atireksd11/Astra-Companion/cad/README.md

# CAD exports

| File | Description |
|---|---|
| [`astra-companion-chassis-assembly.step`](astra-companion-chassis-assembly.step) | Full mechanical assembly (PETG shell, head, chassis plate, motor mounts). Exported from the main Fusion design (`micro_robot_assembly`). |

Open in Fusion 360, FreeCAD, or Onshape. Week 2 Half Life repo copy: [Astra-Companion-Cad](https://github.com/atireksd11/Astra-Companion-Cad).

Renders live in [`docs/images/`](../docs/images/).

Week 4 eye plastic (empty until the model exists): [`eyes/`](eyes/).
