atireksd11/Astra-Companion/docs/README.md

# Docs

| Doc | Contents |
|-----|---|
| [`DEVELOPMENT.md`](DEVELOPMENT.md) | Repo map, firmware modules, weekly scope |
| [`FEATURE19_PHASE6.md`](FEATURE19_PHASE6.md) | Robot `done.actions[]` on ESP32, contract tests, verification |
| [`ROBOT_BRINGUP.md`](ROBOT_BRINGUP.md) | secrets.h, flash, bridge, laptop or robot voice, troubleshooting |
| [`PINOUT.md`](PINOUT.md) | ESP32-S3 GPIO map from the KiCad netlist |
| [`CAD.md`](CAD.md) | Week 2 chassis, prints, mechanical BOM |
| [`WEEK4_EYES.md`](WEEK4_EYES.md) | Dual GC9A01 eyes: plan, pins, later code and CAD folders |
| [`../hardware/BOM_AUDIO_MODULE.md`](../hardware/BOM_AUDIO_MODULE.md) | Audio side box, neck bearings, and MG90S |
| [`HALF_LIFE.md`](HALF_LIFE.md) | Week 1 vs Week 2 upload checklist |
| [`images/`](images/) | PCB render + CAD screenshots for README / Half Life |

Half Life devlog copy lands in root `JOURNAL.md` (synced from the site).
