atireksd11/Astra-Companion/extrude/README.md

# extrude

not this week either.

idea is: throw `astracompanion.ato` at a checker (erc / spice / whatever) and see if it catches dumb stuff like missing pullups or the 6V-into-5V thing.

the robot is the test case. first i have to have a board.
