atireksd11/Astra-Companion/cad/eyes/README.md

# Eye mechanics (Week 4)

Plastic for the two round GC9A01 eyes. The circuit is already on the carrier board. Fusion source stays in [Astra-Companion-Cad](https://github.com/atireksd11/Astra-Companion-Cad). Copy STEP or STL files into the folders below when the model exists.

| Folder | What lands here |
|---|---|
| [bezels/](bezels/) | Printed rings in front of each screen |
| [screen-mounts/](screen-mounts/) | Clips or pockets that hold the 1.28 inch modules |
| [pupil-art/](pupil-art/) | Drawings of the iris and status marks, not 3D parts |

Photos of those parts go in `docs/images/eyes/`. The week plan is [docs/WEEK4_EYES.md](../../docs/WEEK4_EYES.md).
