atireksd11/Astra-Companion/server/detectors/README.md

# Detectors

Each detector reads a `Turn` and writes scores into `turn.notes`.

- **free** — plain math on the robot or laptop
- **cheap** — small local model
- **paid** — cloud API

Detectors that the reply does not need run after the reply starts.
