atireksd11/Astra-Companion/docs/images/cad-exploded.png

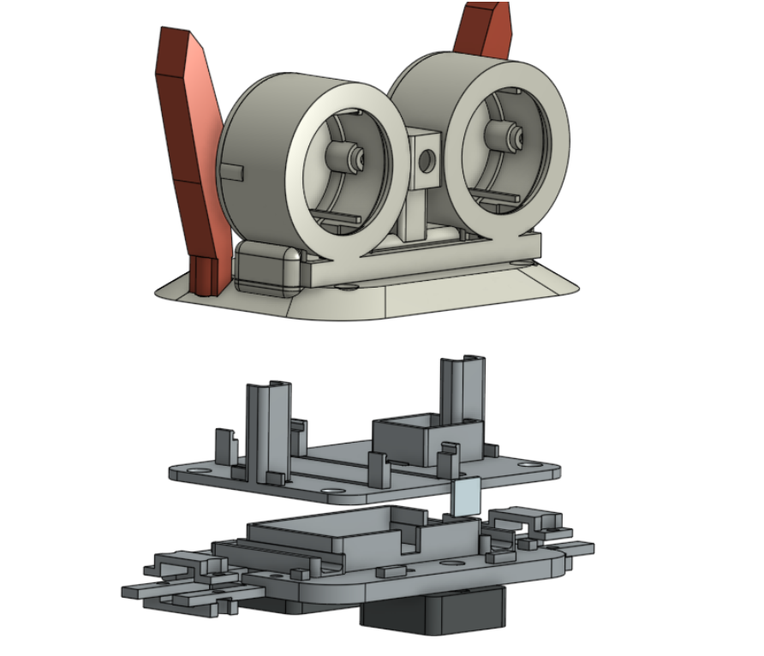
docs/images/cad-exploded.png
