atireksd11/Astra-Companion/docs/images/cad-front.png

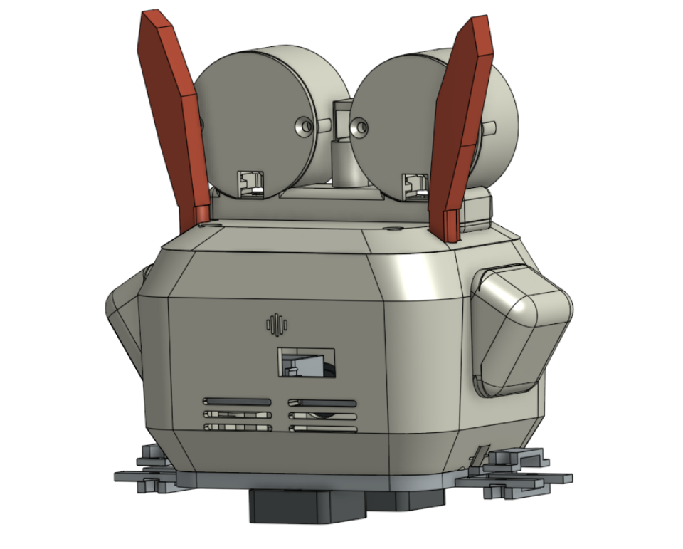
docs/images/cad-front.png
