atireksd11/Astra-Companion/docs/images/cad-iso.png

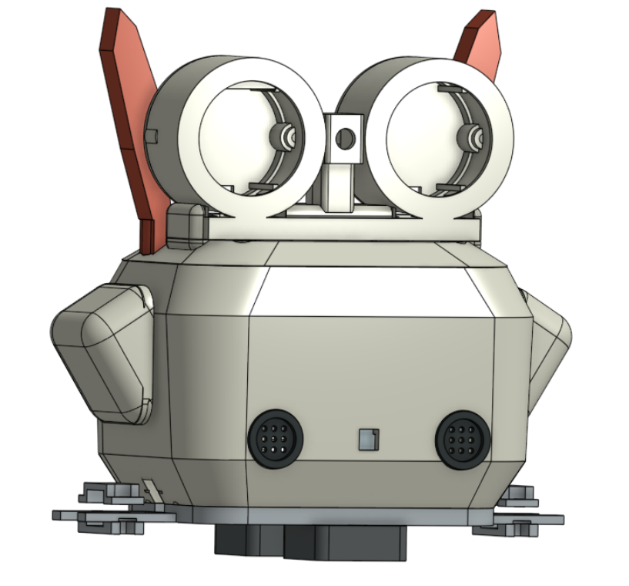
docs/images/cad-iso.png
