atireksd11/Astra-Companion/docs/images/cad-pcb-stack.png

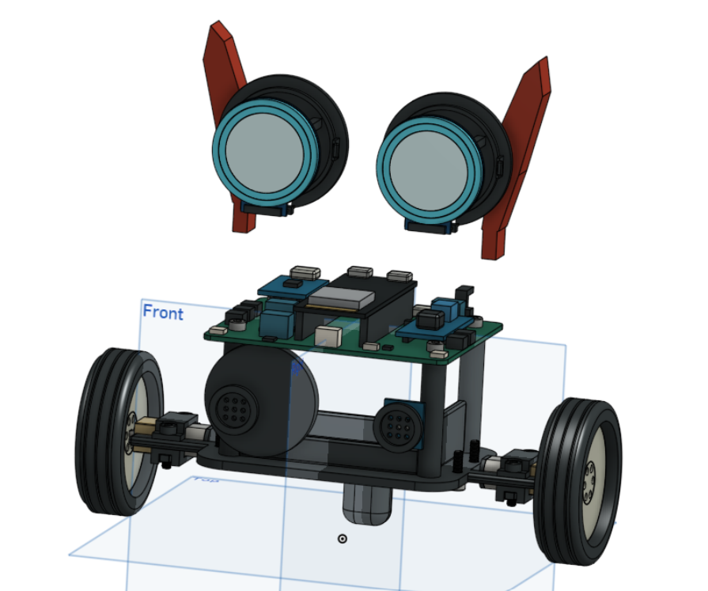
docs/images/cad-pcb-stack.png
