atireksd11/Astra-Companion/docs/images/cad-wheels.png

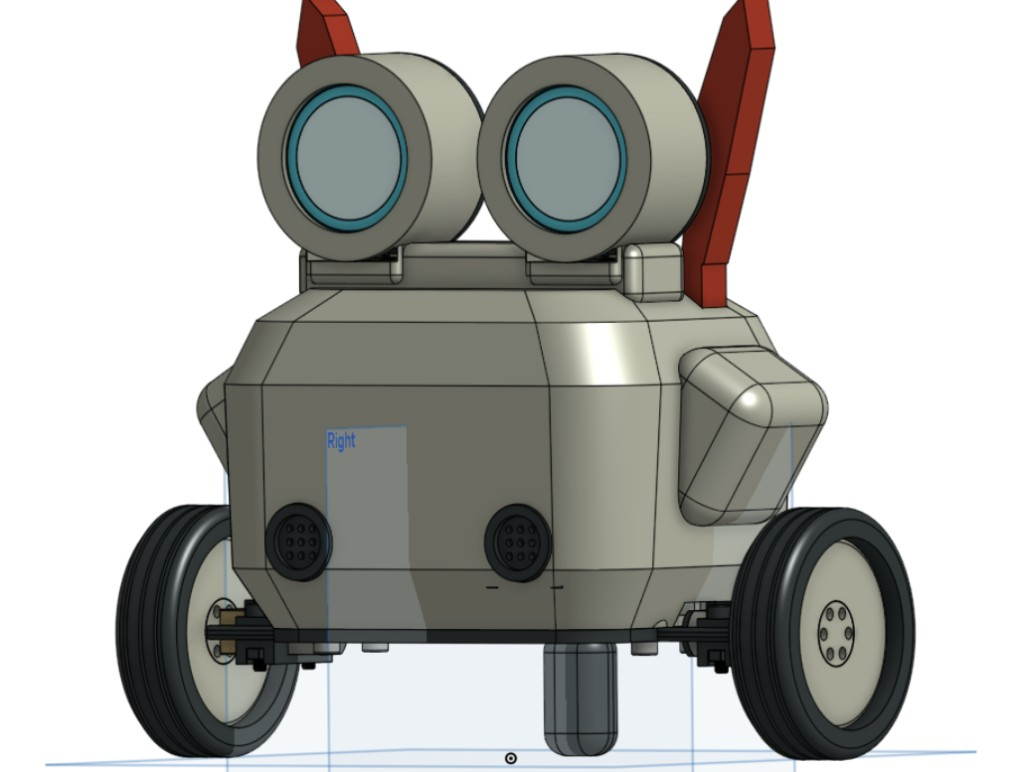
docs/images/cad-wheels.png
