atireksd11/Astra-Companion/hardware/BOM_AUDIO_MODULE.md

# Audio module and neck pivot (this week)

Mechanical parts for the side speaker box, the neck pivot, and head pan. These fit the printed chassis in [Astra-Companion-Cad](https://github.com/atireksd11/Astra-Companion-Cad). The carrier PCB still has INMP441 and MAX98357A. This week is mostly plastic, bearings, and a stronger servo.

Grant import file: [bom-audio-module.csv](bom-audio-module.csv).

| Part | Qty | Unit | Total | Where |
|---|-----|---|---|---|
| [PGN 608-ZZ ball bearings](https://www.amazon.ca/gp/product/B07XLV1W2M/ref=ox_sc_act_title_2?smid=A3RMJZMAP3U4RK&psc=1) (10 pack, 8 by 22 by 7 mm) | 10 | $1.30 | $12.95 | Amazon.ca |
| [MG90S metal gear micro servo](https://www.amazon.ca/gp/product/B0BHYHKF2P/ref=ox_sc_act_title_1?smid=A1AEYBYG92X8UY&psc=1) (2 pack) | 2 | $7.50 | $14.99 | Amazon.ca |
| Tax and shipping | | | about $5.00 | Prime / domestic |

Parts subtotal is **$27.94** before tax and shipping. Unit price is per piece. The totals are the pack prices Amazon charges.

## What each part does

The **608-ZZ bearings** sit at the top and bottom of the neck so the head turns smoothly without grinding on printed plastic.

The **MG90S servos** use metal gears so pan motion does not strip like the old SG90. One servo moves the head left and right. The second from the pack is a spare or a future tilt axis.

## CAD renders

Exploded view of the head, speaker side panel, and neck stack:

Audio module exploded

Rear view with the vented speaker box on the body:

Audio module rear

Inside the torso showing the speaker and board bay:

Audio module internal

Side panel, gasket plates, and speaker mount detail:

Audio module side detail
