atireksd11/Astra-Companion/hardware/BOM_NEEDS_PRICE.md

# BOM pricing notes

**PCB (Week 1):** all lines priced in [`bom.csv`](bom.csv). Tax/shipping math in [`BOM_SUMMARY.md`](BOM_SUMMARY.md).

**CAD (Week 2):** all lines priced in [`bom-cad.csv`](bom-cad.csv). Tier 1 cap in [`BOM_CAD_SUMMARY.md`](BOM_CAD_SUMMARY.md).

Half Life tax field for PCB tier (with ~$96 parts): **`7.00` USD** on the form; you cover the rest of tax and all shipping.
