atireksd11/Astra-Companion/hardware/BOM.md

# Astra Companion — bill of materials

<!-- Generated by Half Life from project cmuvgfgnh00a901q9t8ie3rrb. Edits here are overwritten on the next sync. -->
<!-- Generated: 1970-01-01T00:00:00.000Z -->

> [!NOTE]
> This parts list is mirrored from [Half Life](https://halflife.hackclub.com). Editing it here will not change the platform's copy, and the next sync overwrites this file.

| Week | Tier | Parts funding |
| --- | --- | --- |
| Week 1 | Tier 2 | $65.00 |

The importer that already read this repo uses `hardware/bom.csv` with columns Part, Purpose, Qty, Unit Price (USD), Total Price (USD), Vendor, Link, Notes. Root `BOM.md` has no part columns of its own. The table below is the same list. Qty is the quantity that has to be purchased. PCB manufacturing, shipping, and tax are not included.

| Part | Purpose | Qty | Unit Price (USD) | Total Price (USD) | Vendor | Link | Notes |
| --- | --- | --- | --- | --- | --- | --- | --- |
| ESP32-S3-DEVKITC-1-N8R8 | Main controller. Plugs into U2. | 1 | 15.00 | 15.00 | Mouser | https://www.mouser.com/ProductDetail/Espressif-Systems/ESP32-S3-DevKitC-1-N8R8 | Existing vendor and link kept. Page not reopened on 2026-10-12. Buy 1. |
| DRV8833PWPR | Dual H-bridge. U3. | 1 | 2.10 | 2.10 | LCSC | https://www.lcsc.com/product-detail/C50506.html | Existing vendor and link kept. Page not reopened on 2026-10-12. Buy 1. |
| GC9A01 1.28in 240x240 round LCD module | Round eyes. DS1 and DS2. | 2 | 8.90 | 17.80 | Makerfabs | https://www.makerfabs.com/gc9a01-1-28-inch-round-lcd-module.html | Existing vendor and link kept. Page not reopened on 2026-10-12. Buy 2. |
| MPU-6050 | Balance gyro. U5 bare QFN. | 1 | 20.23 | 20.23 | LCSC | https://www.lcsc.com/product-detail/C24112.html | Existing vendor and link kept. Page not reopened on 2026-10-12. Buy 1. A cheaper module is a later cost cut. The design is unchanged. |
| DS3231M+TRL | Real-time clock. U6. 16-pin wide SOIC. | 1 | 14.29 | 14.29 | DigiKey | https://www.digikey.com/en/products/detail/analog-devices-inc-maxim-integrated/DS3231M-TRL/2402421 | Checked 2026-10-12. Cut-tape price. Package on the page is 16-SOIC, 0.295 inch (7.50 mm) wide. This is not the 8-pin MZ part. Digi-Reel would add a $7 fee, which is not included. |
| VL53L0CXV0DH/1 | Distance sensor. U8. | 1 | 5.18 | 5.18 | Mouser | https://www.mouser.com/ProductDetail/STMicroelectronics/VL53L0CXV0DH-1 | Existing vendor and link kept. Page not reopened on 2026-10-12. Buy 1. The board footprint is still the VL53L1x pattern. |
| MAX98357AETE+T | I2S speaker amplifier. U4. | 1 | 1.33 | 1.33 | LCSC | https://www.lcsc.com/product-detail/C910544.html | Existing vendor and link kept. Page not reopened on 2026-10-12. Buy 1. |
| INMP441 I2S microphone module, 6-pin | Microphone. MK1. | 1 |  |  |  |  | Needs a page that states 6 pins and a USD price. The Elecrow page opened on 2026-10-12 is $5.00 but does not say the pin count. |
| MAX17048G+T10 | Fuel gauge. U10. | 1 | 2.17 | 2.17 | LCSC | https://www.lcsc.com/product-detail/C2682616.html | Existing vendor and link kept. Page not reopened on 2026-10-12. Buy 1. |
| MT3608 boost module | Motor-rail boost. U1. | 1 | 0.95 | 0.95 | ProtoSupplies | https://protosupplies.com/product/mt3608-mini-adjustable-dc-dc-boost-module/ | Existing vendor and link kept. Page not reopened on 2026-10-12. Buy 1. |
| AP2112K-3.3TRG1 | 3.3V regulator. U7. | 5 | 0.08 | 0.40 | LCSC | https://www.lcsc.com/product-detail/C51118.html | Existing vendor and link kept. Page not reopened on 2026-10-12. Minimum buy is 5. One is used. |
| AO3401A | Display power switch. Q4. | 10 | 0.06 | 0.60 | LCSC | https://www.lcsc.com/product-detail/C15127.html | Existing vendor and link kept. Page not reopened on 2026-10-12. Minimum buy is 10. One is used. |
| USBLC6-2SC6 | USB ESD diode. U11. | 5 | 0.18 | 0.90 | LCSC | https://www.lcsc.com/product-detail/C7519.html | Existing vendor and link kept. Page not reopened on 2026-10-12. Minimum buy is 5. One is used. |
| USBLC6-4SC6 | ESD diode. U13. | 5 | 0.17 | 0.85 | LCSC | https://www.lcsc.com/product-detail/C111212.html | Existing vendor and link kept. Page not reopened on 2026-10-12. Minimum buy is 5. One is used. |
| TYPE-C-31-M-12 | USB-C receptacle. J4. | 5 | 0.19 | 0.95 | LCSC | https://www.lcsc.com/product-detail/C165948.html | Existing vendor and link kept. Page not reopened on 2026-10-12. Minimum buy is 5. One is used. |
| PTS645 tactile switch | User buttons. SW1 SW3 SW6. | 5 | 0.21 | 1.05 | LCSC | https://www.lcsc.com/product-detail/C221880.html | Existing vendor and link kept. Page not reopened on 2026-10-12. Minimum buy is 5. Three are used. |
| WS2812B | Status LEDs. D7 and D8. | 5 | 0.10 | 0.50 | LCSC | https://www.lcsc.com/product-detail/C114586.html | Existing vendor and link kept. Page not reopened on 2026-10-12. Minimum buy is 5. Two are used. |
| 0.1uF 0805 capacitor | Decoupling. | 20 | 0.02 | 0.40 | LCSC | https://www.lcsc.com/product-detail/C1711.html | Existing vendor and link kept. Page not reopened on 2026-10-12. Minimum buy is 20. Eighteen 0805 parts are on the board. |
| TP4056 USB-C charger module with DW01 | Charger. TP1. | 1 |  |  |  |  | Needs a USD page. The module must show IN+ IN- B+ B- OUT+ OUT- and a DW01 chip. No page opened on 2026-10-12 stated all of that in USD. |
| Slide switch | Power switch. SW2. | 1 |  |  |  |  | Schematic footprint name is SW_Slide_SPDT_Straight_CK_OS102011MS2Q. No USD page opened on 2026-10-12. |
| Molex 1040310811 microSD slot | Card socket. J6. | 1 | 2.21 | 2.21 | DigiKey | https://www.digikey.com/en/products/detail/molex/1040310811/2370379 | Checked 2026-10-12. Cut-tape price for one. Description: microSD card connector, surface mount, right angle. Digi-Reel would add a $7 fee, which is not included. |
| CR2032 coin cell holder | Coin cell holder. BT2. | 1 |  |  |  |  | Footprint name is BatteryHolder_Keystone_3000. No price page opened on 2026-10-12. |
| CR2032 coin cell | Cell for BT2. | 1 |  |  |  |  | No price page opened on 2026-10-12. |
| BAT54C | Diode. D5. | 1 |  |  |  |  | No price page opened on 2026-10-12. |
| 1N5819 | Schottky diode. D1. | 1 |  |  |  |  | No price page opened on 2026-10-12. |
| Phoenix screw terminal 1x2 | J1 and J2. | 2 |  |  |  |  | No price page opened on 2026-10-12. |
| Metz screw terminal 1x2 | J5. | 1 |  |  |  |  | No price page opened on 2026-10-12. |
| Pin header 1x7 | Display connectors. DS1 and DS2. | 2 |  |  |  |  | No price page opened on 2026-10-12. |
| Pin header 1x6 | Header for the TP4056 module. TP1. | 1 |  |  |  |  | No price page opened on 2026-10-12. |
| Pin header 1x4 | Header for the boost module. U1. | 1 |  |  |  |  | No price page opened on 2026-10-12. |
| JST SH 4-pin 1.0 mm connector plus cable | I2C connector. J7. | 1 |  |  |  |  | Needs one listing that includes the connector and the cable. No price page opened on 2026-10-12. |
| Pin header 1x3 | Servo headers. J3 and J10. | 2 |  |  |  |  | No price page opened on 2026-10-12. |
| Fan pin header 1x3 | Encoder connectors. J9 and Jd1. | 2 |  |  |  |  | No price page opened on 2026-10-12. |
| Pin header 1x1 | Test point. J8. | 1 |  |  |  |  | No price page opened on 2026-10-12. |
| Female header 1x22 | Sockets for the DevKit. | 2 |  |  |  |  | No price page opened on 2026-10-12. The symbol has 22 pins per side. The placed footprint is 2x19. |
| JST PH 2-pin plus 18650 holder with leads | Battery plug and holder. BT1. | 1 |  |  |  |  | No single page opened on 2026-10-12 sells this pair. The Keystone 1042 row is deleted because that footprint is not on the board. |
| 10k 0805 resistor | Pull-ups. R1 R9 R12 R13 R14 R15 R16 R17 R18 R19 R20 R27 R29 R30 R32 R36 R37 R38. | 100 | 0.0034 | 0.34 | LCSC | https://www.lcsc.com/product-detail/C881248.html | Checked 2026-10-12. EVER OHMS CR0805F10K0P05Z, 10k 1% 0805. Need 18. Minimum purchase is 100 at $0.0034, total $0.34. |
| 5.1k axial resistor | R4 and R5. | 2 |  |  |  |  | No price page opened on 2026-10-12. |
| 2.2k 0805 resistor | R10 and R11. | 2 |  |  |  |  | No price page opened on 2026-10-12. |
| 1k 0805 resistor | R25. | 1 |  |  |  |  | No price page opened on 2026-10-12. |
| 100k 0805 resistor | R28. | 1 |  |  |  |  | No price page opened on 2026-10-12. |
| 330 ohm 0805 resistor | R39. | 100 | 0.0029 | 0.29 | LCSC | https://www.lcsc.com/product-detail/C881004.html | Checked 2026-10-12. EVER OHMS CR0805J330RP05Z, 330 ohm 5% 0805. Need 1. Minimum purchase is 100 at $0.0029, total $0.29. |
| 0.2 ohm 1% resistor, 0.5 W or higher | R23 and R24. | 2 |  |  |  |  | No page opened on 2026-10-12 showed this value, tolerance, and power rating with a USD price. |
| 2.2uF 0805 capacitor | C14 and C50. | 2 |  |  |  |  | No price page opened on 2026-10-12. |
| 10uF 1206 capacitor | C4 C24 C26 C28. | 4 |  |  |  |  | No price page opened on 2026-10-12. |
| 10uF 0805 capacitor | C15. | 1 |  |  |  |  | No price page opened on 2026-10-12. |
| 22uF 0805 capacitor | C20. | 1 |  |  |  |  | No price page opened on 2026-10-12. |
| 100uF radial capacitor | C2. | 1 |  |  |  |  | No price page opened on 2026-10-12. |
| 100uF electrolytic capacitor | C23. | 1 |  |  |  |  | No price page opened on 2026-10-12. |
| 1000uF radial capacitor | C3. | 1 |  |  |  |  | No price page opened on 2026-10-12. |
| 2.2nF 0805 capacitor | C12. | 1 |  |  |  |  | No price page opened on 2026-10-12. |
| 10nF 0805 capacitor | C10 and C19. | 2 |  |  |  |  | No price page opened on 2026-10-12. |
| 1uF disc capacitor | C1. | 1 |  |  |  |  | No price page opened on 2026-10-12. |
| 0.1uF disc capacitor | C8. | 1 |  |  |  |  | No price page opened on 2026-10-12. |
| 0.1uF 0603 capacitor | C13. | 1 |  |  |  |  | No price page opened on 2026-10-12. |
| LED 0805 | D3. | 1 |  |  |  |  | No price page opened on 2026-10-12. |
| Reset button | SW4. | 1 |  |  |  |  | No price page opened on 2026-10-12. |
| Boot button | SW5. | 1 |  |  |  |  | No price page opened on 2026-10-12. |
| 6V N20 micro gear motor with rubber wheel, 1 pair | Wheel motors. Two motors. | 1 | 18.39 | 18.39 | RobotShop | https://www.robotshop.com/products/6v-n20-micro-gear-motor-w-rubber-wheel-1-pair | Checked 2026-10-12. One pair includes 2 motors and 2 wheels, which is the quantity needed. Sale price $18.39. Shipping and the tariff note on the page are not included. |
| MG90S servo | Servos. | 2 | 9.00 | 18.00 | Tower Pro | https://torqpro.com/product/mg90s/ | Checked 2026-10-12. $9.00 each. Buy 2. The page does not show a multi-pack minimum. |
| Mini metal speaker 8 ohm 0.5W | Speaker for the MAX98357A. | 1 | 1.95 | 1.95 | Adafruit | https://www.adafruit.com/product/1890 | Checked 2026-10-12. Price $1.95. The page said out of stock. |
| 18650 cell, protected, 2200mAh | Main battery. | 1 | 9.95 | 9.95 | Adafruit | https://www.adafruit.com/product/1781 | Checked 2026-10-12. Protected 3.7 V 2200 mAh cell, 69 mm by 18 mm, with a JST-PH pigtail. In stock at $9.95. This is the cell, not the holder. |
| microSD card | Card for J6. | 1 |  |  |  |  | No price page opened on 2026-10-12. |
| Subtotal of priced rows | Sum of Total Price. Shipping and tax are not included. PCB manufacturing is not included. |  |  | 135.83 |  |  | Checked 2026-10-12. |
| Rows still needing a price | Count of part rows with an empty price. | 39 |  |  |  |  | See the Needs price section. |
| Tiers: $65 or $100 | Which tier this subtotal fits under. |  |  |  |  |  | Subtotal $135.83 is above both $65 and $100. |

## Needs price

- INMP441 I2S microphone module, 6-pin
- TP4056 USB-C charger module with DW01
- Slide switch
- CR2032 coin cell holder
- CR2032 coin cell
- BAT54C
- 1N5819
- Phoenix screw terminal 1x2
- Metz screw terminal 1x2
- Pin header 1x7
- Pin header 1x6
- Pin header 1x4
- JST SH 4-pin 1.0 mm connector plus cable
- Pin header 1x3
- Fan pin header 1x3
- Pin header 1x1
- Female header 1x22
- JST PH 2-pin plus 18650 holder with leads
- 5.1k axial resistor
- 2.2k 0805 resistor
- 1k 0805 resistor
- 100k 0805 resistor
- 0.2 ohm 1% resistor, 0.5 W or higher
- 2.2uF 0805 capacitor
- 10uF 1206 capacitor
- 10uF 0805 capacitor
- 22uF 0805 capacitor
- 100uF radial capacitor
- 100uF electrolytic capacitor
- 1000uF radial capacitor
- 2.2nF 0805 capacitor
- 10nF 0805 capacitor
- 1uF disc capacitor
- 0.1uF disc capacitor
- 0.1uF 0603 capacitor
- LED 0805
- Reset button
- Boot button
- microSD card
