atireksd11/Astra-Companion/hardware/bom-passives-lcsc.csv

Part | Purpose | Qty | Unit Price (USD) | Total Price (USD) | Vendor | Link | Notes
Resistor assortment 0805 and axial | 10k x18, 5.1k x2, 2.2k x2, 1k, 100k, 330 ohm. | 6 | 0.495 | 2.97 | LCSC |  | NOT ON HALF LIFE TIER. Order with LCSC SMD order; six packs $2.97 on the sheet.
Capacitor and LED assortment | 0805, 1206, radial, disc, 0603 caps plus one 0805 LED. | 11 | 1.111 | 12.23 | LCSC |  | NOT ON HALF LIFE TIER. Eleven LCSC packs $12.23 on the sheet.
