atireksd11/Astra-Companion/hardware/bom-week2.csv

Part | Purpose | Qty | Unit Price (USD) | Total Price (USD) | Vendor | Link | Notes
N20 encoder motor pair, 6V, about 300 RPM | Two wheel motors in one pack. | 1 | 19.38 | 19.38 | Amazon.ca |  | WEEK2-CAD. Meccanixity CAD 27.69 pair at 0.70. Import for enclosure/mechanical tier.
N20 wheels, 43 mm, 1 pair | Rubber wheels for the N20 shafts. | 1 | 3.50 | 3.50 | DFRobot |  | WEEK2-CAD. $3.50 on the sheet.
Molicel P30 18650 | Main cell BT1. | 1 | 13.65 | 13.65 | Battery Canada |  | WEEK2-CAD. CAD 19.50 at 0.70.
18650 holder with leads | Holds the cell; wires to JST PH on the PCB. | 1 | 1.37 | 1.37 | BC Robotics |  | WEEK2-CAD. CAD 1.95 at 0.70.
MG90S servo | Two servos J3 and J10. | 2 | 4.20 | 8.40 | BC Robotics |  | WEEK2-CAD. CAD 6.00 each at 0.70.
microSD card 8GB Class 10 | Card for J6 when SD is populated. | 1 | 20.99 | 20.99 | Amazon.ca | https://www.amazon.ca/Sandisk-MicroSDHC-Memory-Card-Adapter/dp/B000WH6H1M | WEEK2-CAD. Optional until SD socket is populated. CAD 29.99 at 0.70.
