atireksd11/Astra-Companion/cad/astra-companion-chassis-assembly.step

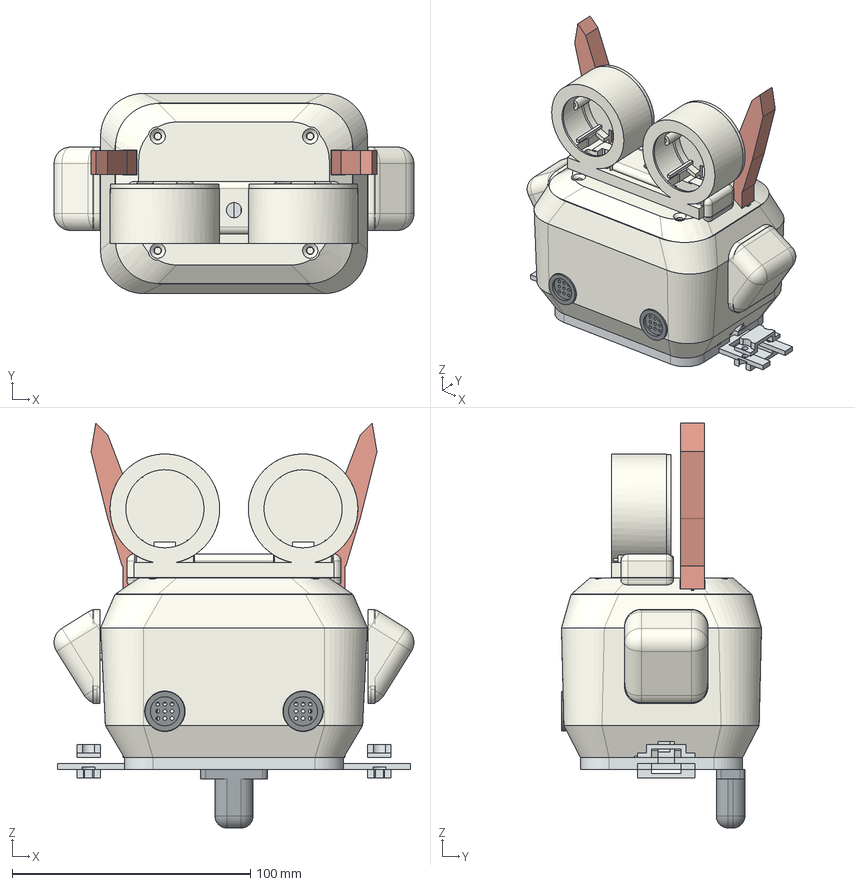
[picture p14: CAD file, 2026-10-19]
cad/astra-companion-chassis-assembly.step
151.1 x 84.0 x 170.0 mm
Main_torso_—_2_5_mm_open_shell
Left_removable_side_pod
Right_removable_side_pod
Speaker_grille
Microphone_port
Bottom_floorplate_—_motor_bays_and_battery_pocket
Removable_electronics_tray_—_ESP32-S3_and_DRV8833
Rear_skid_—_print_flat_attachment_face_down
Left_N20_removable_clamp
Right_N20_removable_clamp
Left_lower_motor_cradle
Right_lower_motor_cradle
Neck_lid_—_removable_head_service_cover
Dual-eye_carrier_—_1_mm_front_lips
Left_removable_eye_rear_cap
Right_removable_eye_rear_cap
Left_removable_ear
Right_removable_ear
