atireksd11/Astra-Companion/(commit log)

2026-10-06 Complete the atopile netlist and lock BOM, pinout, and repo docs.
2026-10-06 Expand BOM with fasteners, wiring, tools, and missing board parts.
2026-10-12 Add KiCad project
2026-10-12 Add firmware skeleton and document the current hardware
2026-10-12 Add PCB render to README
2026-10-12 Add importable BOM CSV
2026-10-12 Add the rest of the priced schematic parts
2026-10-12 List the schematic parts the priced BOM left out
2026-10-12 BOM: verified prices and corrected parts
2026-10-12 BOM: CORE vs DNP, sourced prices
2026-10-12 BOM: full priced list, including the CAD parts
2026-10-12 BOM: one purchasable row per part, no do-not-buy lines
2026-10-12 BOM: price speaker and optional SD/backup cell lines.
    Half Life import no longer has blank unit prices on those four rows.
2026-10-12 Split BOM for Week 1 PCB tier vs Week 2 mechanical tier.
    Half Life imports bom.csv only (~$90 under $100); motors, battery, passives, and DNP moved to separate CSVs.
2026-10-12 Keep only bom.csv for Half Life; move other lists to BOM_SUMMARY.
    Remove extra BOM CSV files so repo import cannot pull optional or Week 2 lines.
2026-10-12 BOM: USD-only prices and Half Life tax/shipping estimate.
    CAD storefront lines use 0.70 USD/CAD; document $12.50 tax and shipping for Week 1.
2026-10-12 BOM: fix MAX98357, ESP32 CAD, GC9A01 Universal Solder CAD.
    ESP32 and displays stay CAD in the CSV; USD rollup excludes Currency CAD rows.
2026-10-12 BOM: add Currency column; CAD/USD native prices; tax/shipping 56 USD.
    Replace mixed-column FX with explicit currency and document shipping+HST estimate.
2026-10-12 Docs: HST on CAD checkout plus import tax on USD orders
2026-10-19 Cad Model Design for my Robot
    This is my CAD model design, with the frame, gaps, spaces, and airflow vents. It has all the feature and space my final design will need.
2026-10-19 Add Week 2 CAD BOM, chassis renders, and Half Life docs.
    Separate bom-cad.csv for the ~$30 tier, copy CAD screenshots into docs/images,
    and document how Week 1 PCB vs Week 2 mechanics split on the platform.
2026-10-19 Point Week 2 docs at the separate CAD GitHub repo.
    Keeps Half Life Tier 1 mechanics separate from the main KiCad project.
2026-10-19 Add chassis STEP under cad/ with a clear filename.
    Moved Fusion export from the messy root name to
    cad/astra-companion-chassis-assembly.step and linked it in the docs.
2026-10-25 Add PCB layout and 3D photos to README.
2026-10-26 Add the audio-module BOM without the 8mm neck shaft tube.
2026-10-26 Add Amazon links and per-piece prices for the bearings and MG90S.
2026-10-26 Ship the laptop voice stack, Phase 6 robot contract, and ESP32 firmware.
    Local secrets, config, and databases stay gitignored.
2026-11-04 checking if pcb change showed up
